witek117/AUPSC/s11.JPG

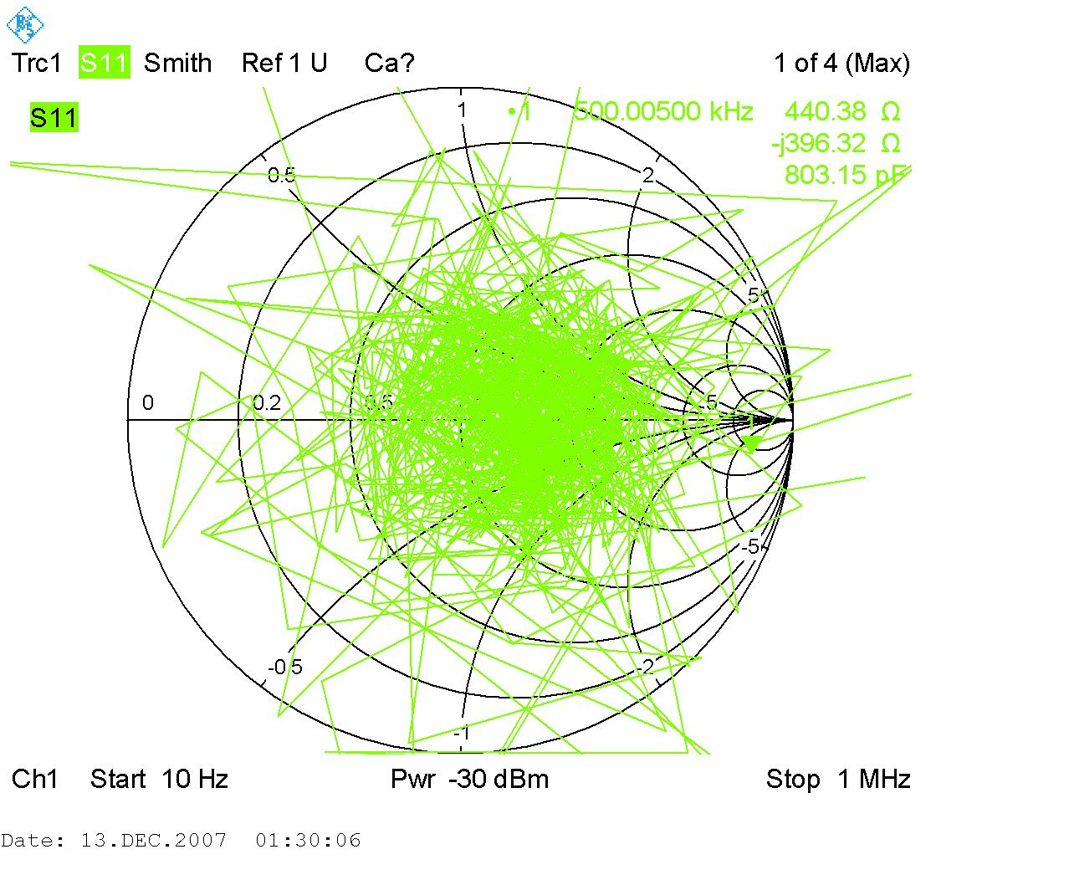
s11.JPG
