witek117/AUPSC/bw100Hz_RMS_10MHz_noise_esrp.PNG

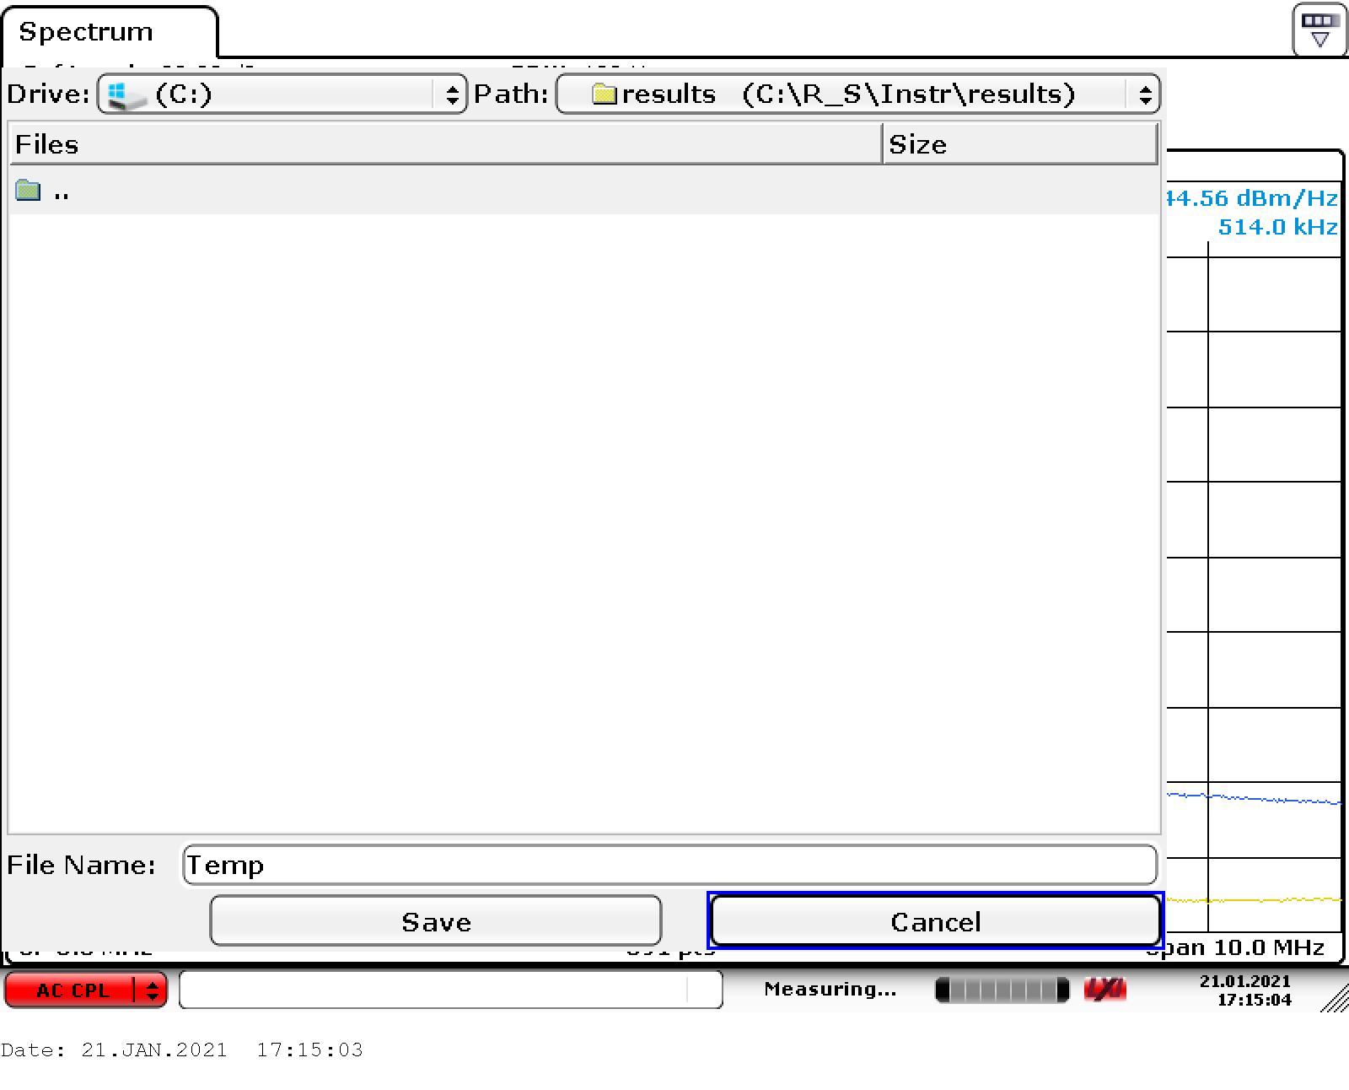
bw100Hz_RMS_10MHz_noise_esrp.PNG
