witek117/AUPSC/AUPSC.pdf

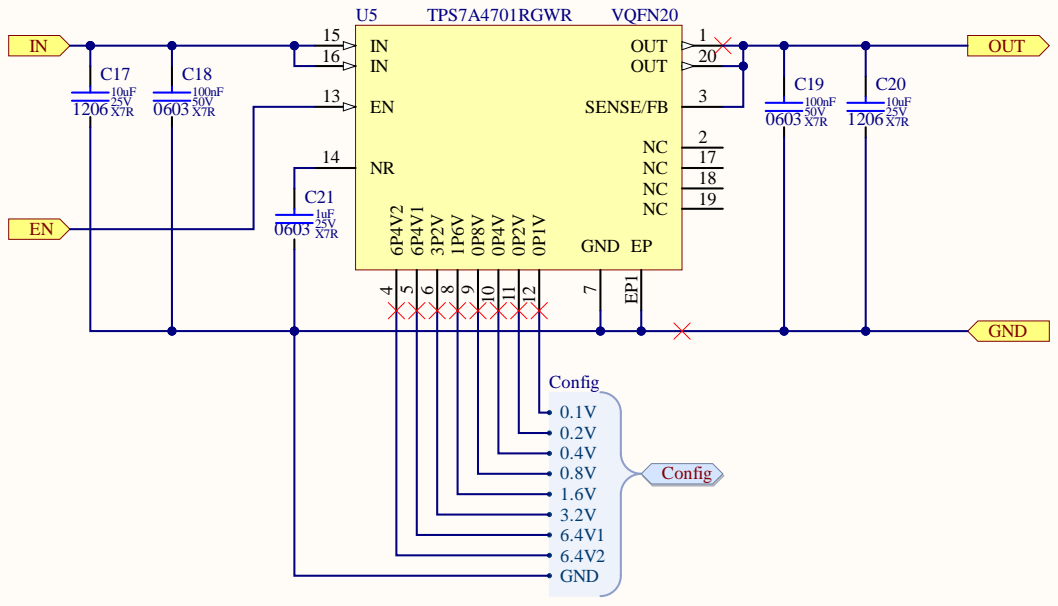
[picture p13: page 1]

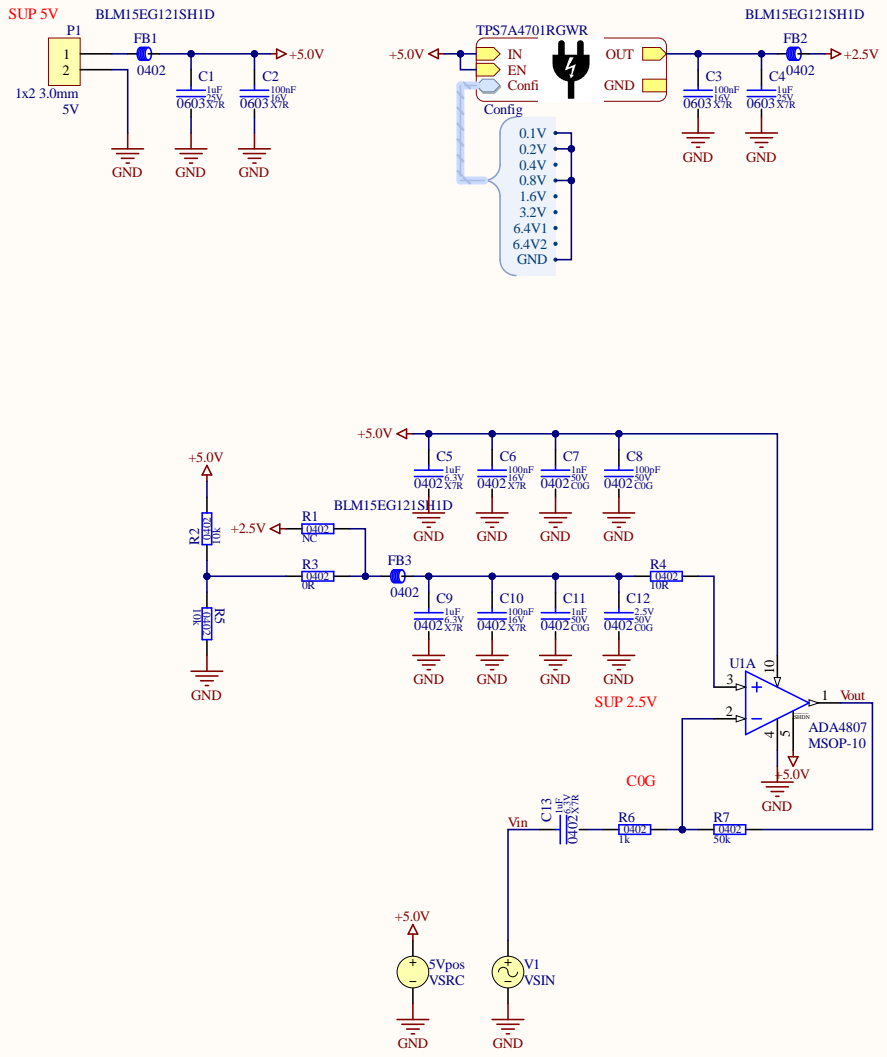
[picture p14: page 2]

D:\Git\AUPSC\AUPSC.SchDoc
