witek117/AUPSC/LTSpice/auspc_v3_ltc6228.asc

C1: cap; 100µ
R1: res; 50
R3: res; 50
R4: res; 80k
R5: res; 80k
R6: res; 75
R7: res; 50
R8: res; 50
R9: res; 100k
U1: LTC6228
U2: LTC6228
V1: voltage; 3
V2: voltage; 3
V4: voltage; SINE(0 1u 30k); AC 1u
Named nets: 0, out2, input, out_sum, in, out1
;ac dec 100 100 10Meg
;tran 0 300us 100ns
.meas AC out1_max MAX MAG(V(out1))
.noise V(out_sum) V4 dec 1000 1 120k
.meas AC f_3db when MAG(V(out1)=out1_max/sqrt(2))
