witek117/AUPSC/LTSpice/auspc_v2.asc

C1: cap; 47µ
R1: res; 50
R3: res; 50
R4: res; 50k
R5: res; 50k
R6: res; 500
R7: res; 50
R8: res; 50
R9: res; 100k
U1: ADA4807
U2: ADA4807
V1: voltage; 3
V2: voltage; 3
V4: voltage; SINE(0 1u 30k); AC 1u
Named nets: 0, out, input, out_sum, in
;ac dec 100 100 10Meg
;tran 0 100us 100ns
.meas AC BW V(out2)
.noise V(out_sum) V4 dec 1000 1 100k
