witek117/AUPSC/(list of files, drawings)

Other design files:
AUPSC.PcbDoc
AUPSC.PrjPcb
AUPSC.SchDoc
