witek117/AUPSC/(commit log)

2020-11-19 po konsulacjach
    [AUPSC.PrjPcb, AUPSC.SchDoc, AUPSC.sdf]
2020-11-24 added version 2 simulation file - non-inverting opamp with symetric power supply
2020-11-30 changed schematic to parallel op amps
2020-12-06 schematic begin
    [AUPSC.PrjPcb, AUPSC.SchDoc]
